jinhwanlazy/wood-case-keyboard/(commit log)

2017-08-31 Set block size same as A4
    [common.scad]
2017-08-31 Fix models to make flat top and change switch to alps
    [base.scad, common.scad, plate.scad, preview.scad, top_cutout.scad]
2019-11-10 add hhkbSA.layout
    [plate.scad]
